alusch/EPaperPictureFrame/system/LowBattery.png

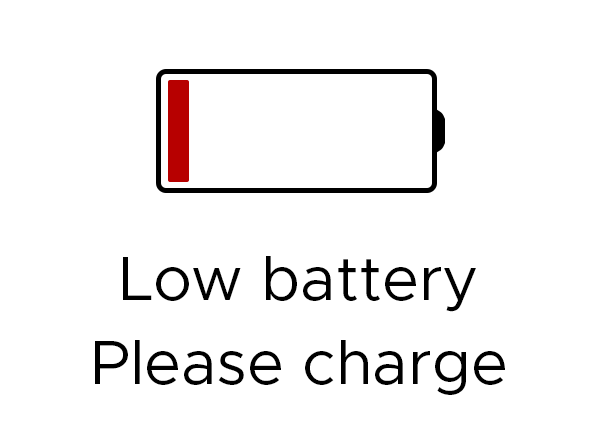
system/LowBattery.png
